galradek/20MHz_DDS_Waveform_Generator/Source code/menu.h

/*
 * menu.h
 *
 * Created: 07.03.2020 18:17:25
 *  Author: Radek
 */ 
void pwm_menu( void);		// Setting PWM modulation
void pulse_menu( void);		// Extended setting pulse duty and slope
void am_menu( void);		// Setting AM modulation
void fm_menu( void);		// Setting FM modulation
void pm_menu( void);		// Setting PM modulation
void fsk_menu( void);		// FSK setting menu
void psk_menu( void);		// PSK setting menu
void sweep_menu_2( void);	// Extended sweep menu
void sweep_menu_1( void);	// Main sweep menu
void burst_menu( void);		// Burst setting menu
void utility_menu( void);	// Service and utility menu
